Leon112211/Tooth_Trace_Rebuild/analysis/output/original/by_sensor.png

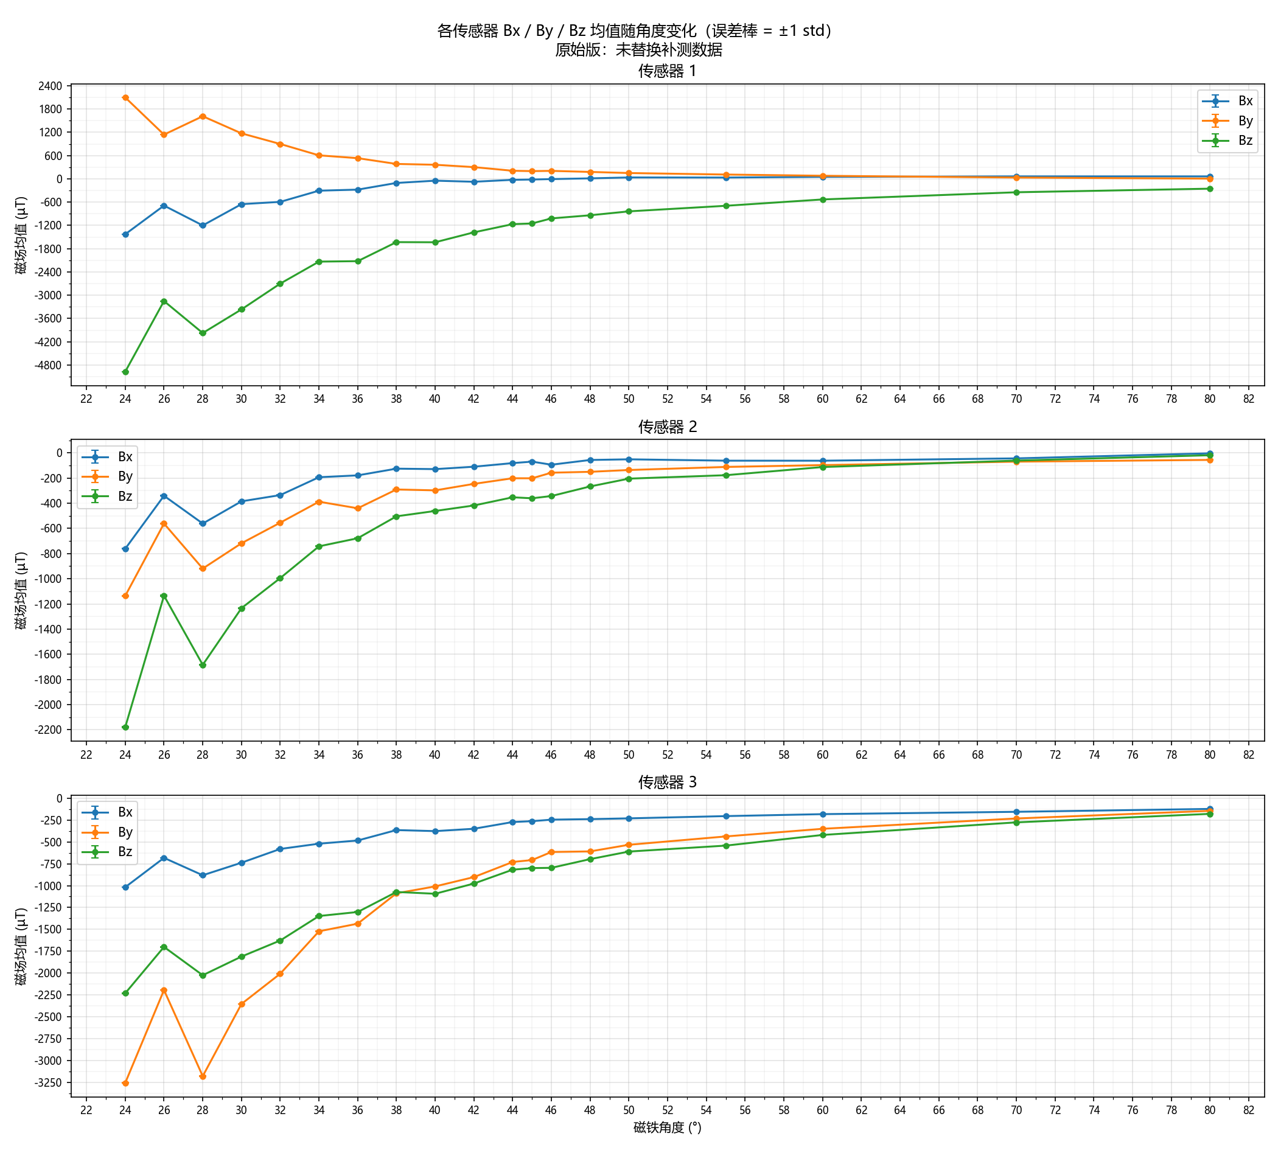
analysis/output/original/by_sensor.png
