Leon112211/Tooth_Trace_Rebuild/analysis/output/replaced/by_sensor.png

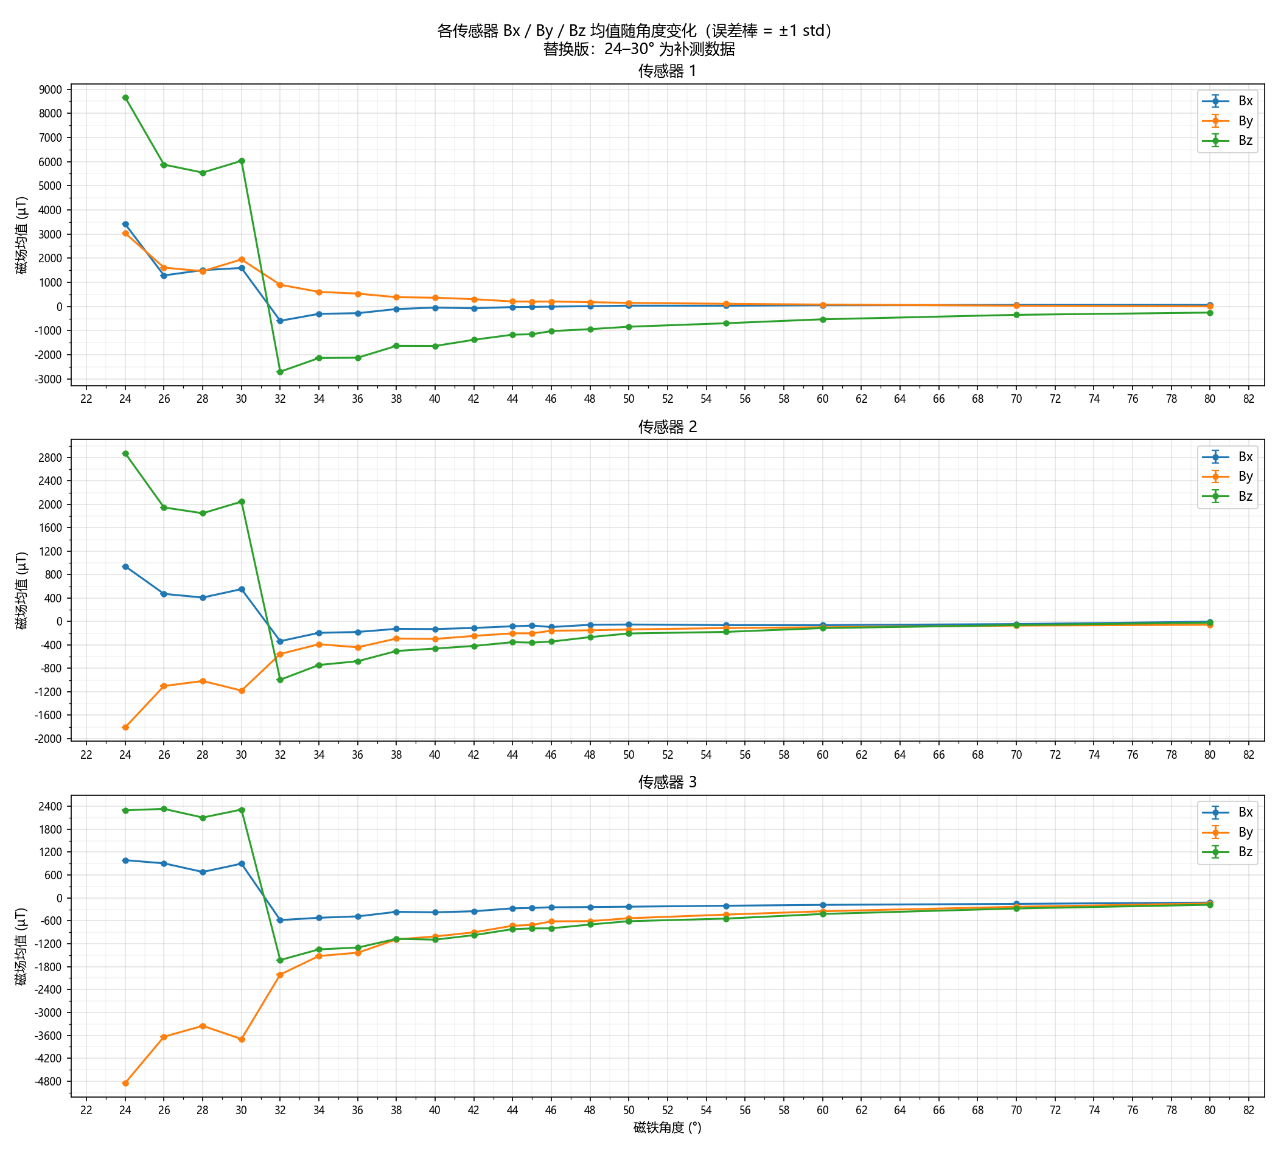
analysis/output/replaced/by_sensor.png
