Leon112211/Tooth_Trace_Rebuild/ui_demo/upper_arch.webp

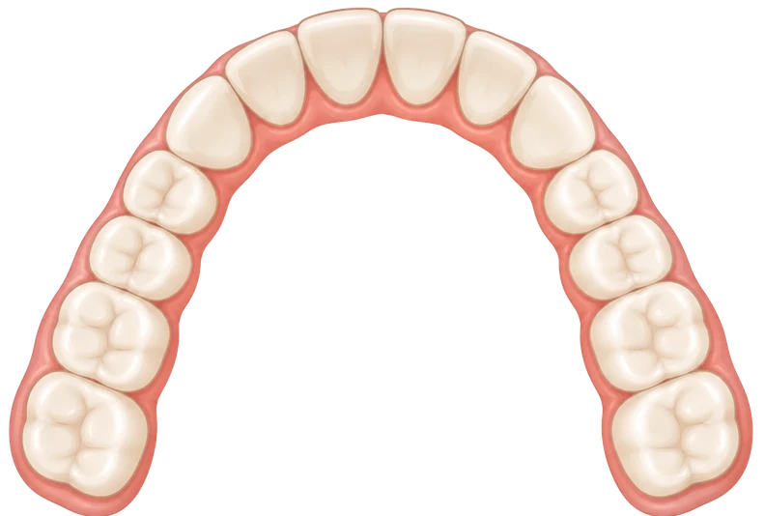
ui_demo/upper_arch.webp
