Leon112211/Tooth_Trace_Rebuild/ui_demo/upper_arch_src.webp

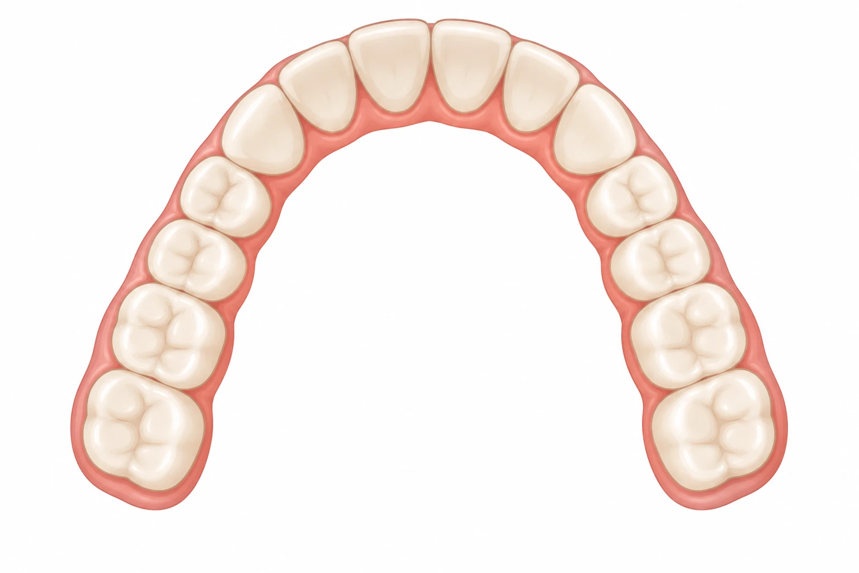
ui_demo/upper_arch_src.webp
